dougray/pi-camera-case/pi-camera-case-sheet.png

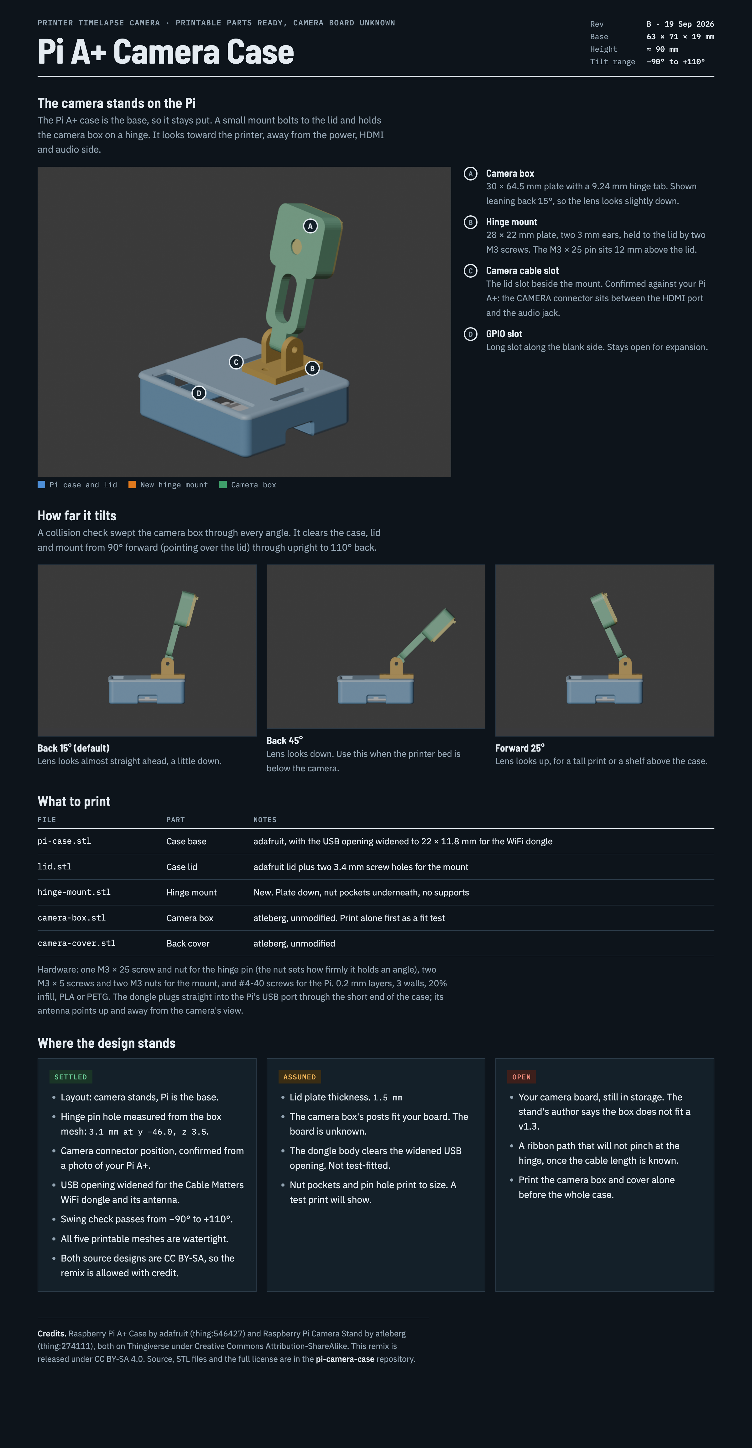
pi-camera-case-sheet.png
