dougray/pi-camera-case/originals/piaplus-case.stl

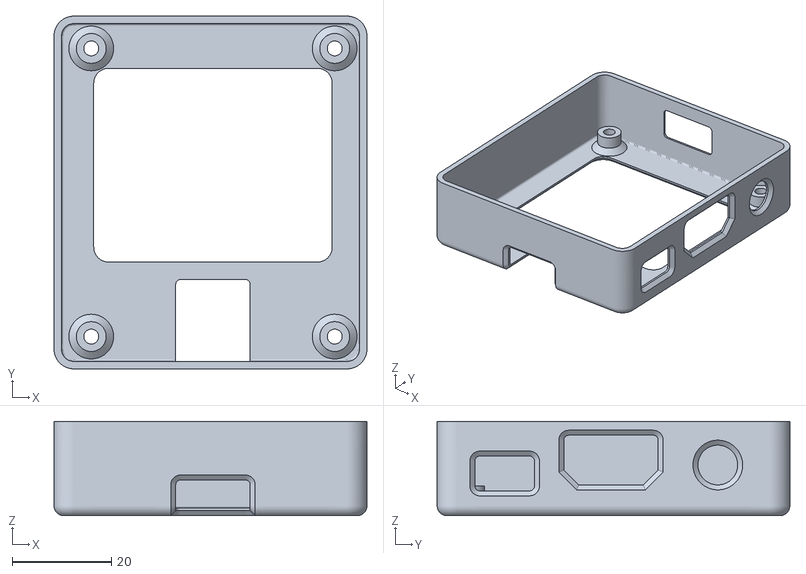
[picture p2: CAD file, 2026-09-19]
originals/piaplus-case.stl
63.0 x 71.0 x 19.0
