dougray/pi-camera-case/stl/hinge-mount.stl

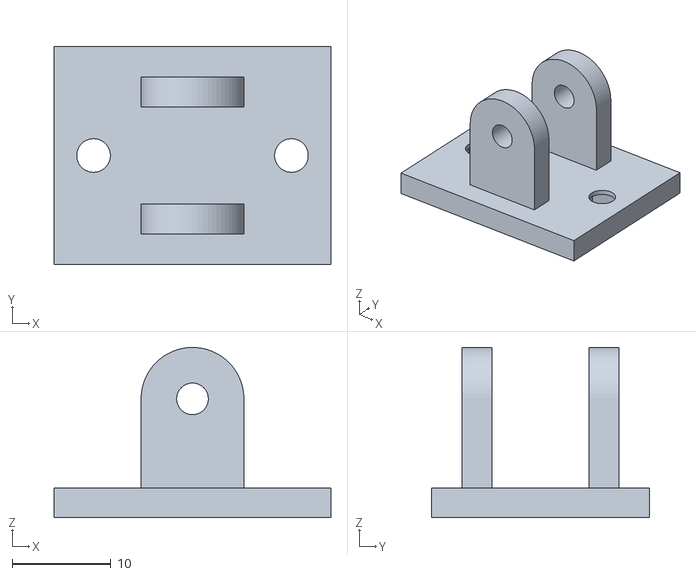
[picture p3: CAD file, 2026-09-19]
stl/hinge-mount.stl
28.0 x 22.0 x 17.2
