dougray/pi-camera-case/originals/piaplus-top.stl

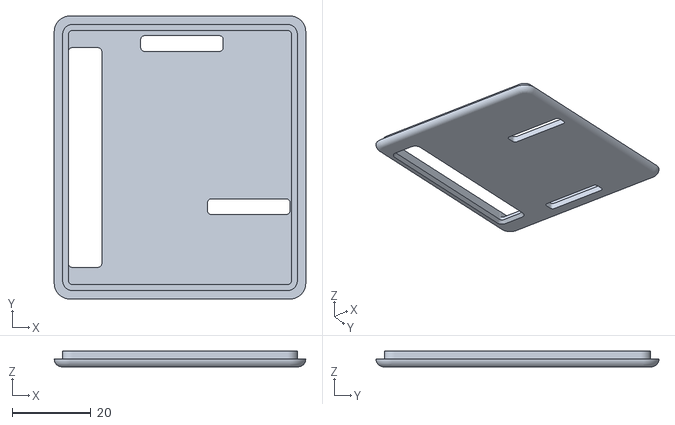
[picture p4: CAD file, 2026-09-19]
originals/piaplus-top.stl
64.0 x 72.0 x 4.00
