dougray/pi-camera-case/stl/camera-cover.stl

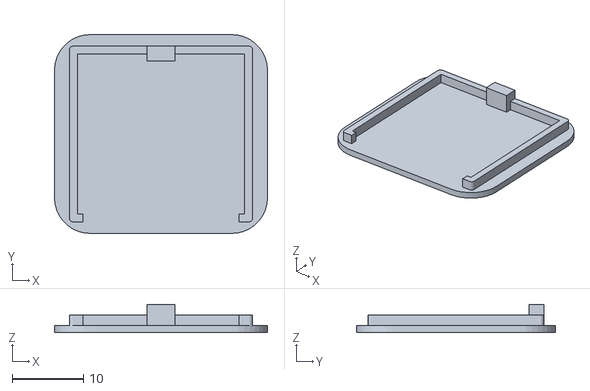
[picture p5: CAD file, 2026-09-19]
stl/camera-cover.stl
30.0 x 28.0 x 4.00
