dougray/pi-camera-case/stl/pi-case.stl

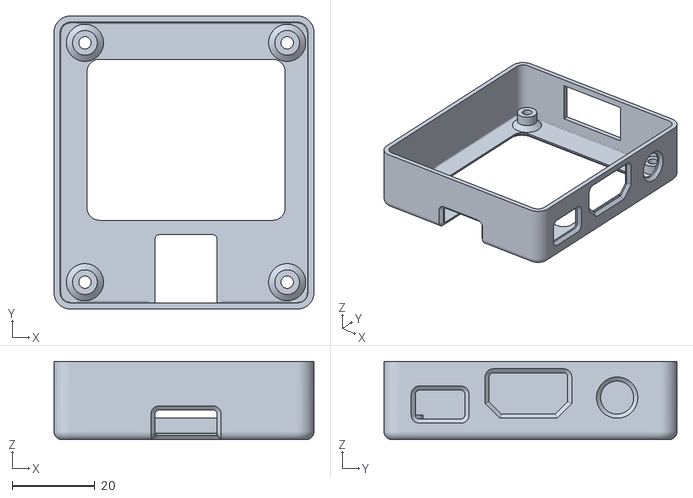
[picture p6: CAD file, 2026-09-19]
stl/pi-case.stl
63.0 x 71.0 x 19.0
