dougray/pi-camera-case/stl/camera-box.stl

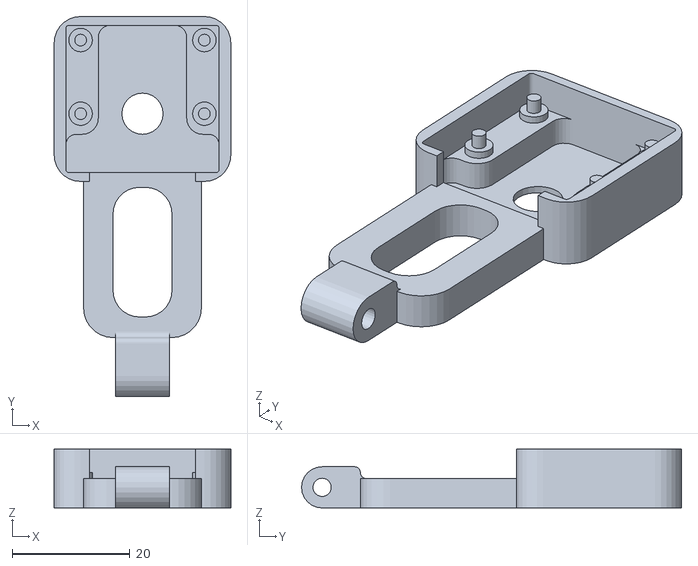
[picture p7: CAD file, 2026-09-19]
stl/camera-box.stl
30.0 x 64.5 x 10.0
