dougray/pi-camera-case/(list of files, cad)

Other CAD files:
stl/lid.stl
